MathysB21/Kubi/art/1K/Kubi - Beach eating ice cream.jpg

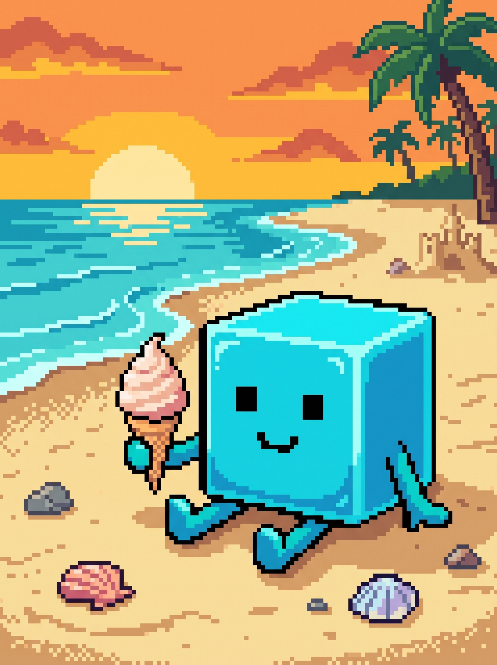
art/1K/Kubi - Beach eating ice cream.jpg
