MathysB21/Kubi/art/Scaled Down/Kubi - Birthday.jpg

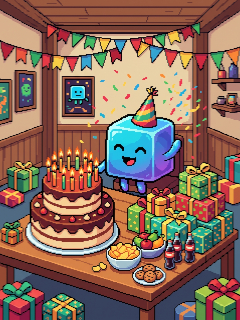
art/Scaled Down/Kubi - Birthday.jpg
