MathysB21/Kubi/docs/knowledge/index.md

# Project Kubi Knowledge Index

> [!IMPORTANT]
> **Agent Reading Rule**:
> ONLY read this index file first. Review the catalog below to find the specific document(s) relevant to your task.
> **DO NOT read all knowledge documents into context** — load only the specific document(s) you need.

## Knowledge Catalog

| Document | Date | Topics / Description |
| :--- | :--- | :--- |
| [`2026-09-05-pomodoro-idle-start-and-persistence.md`](./2026-09-05-pomodoro-idle-start-and-persistence.md) | 2026-09-05 | Pomodoro idle state (`_isStarted`), arcade slow-flashing START prompt, minimal white PAUSED UI, and pause state persistence across face changes. |
| [`2026-09-05-audio-chimes-and-long-break-fanfare.md`](./2026-09-05-audio-chimes-and-long-break-fanfare.md) | 2026-09-05 | Audio chime palette, 7-note celebratory Long Break fanfare (`CHIME_POMODORO_LONG_BREAK`), simulator telemetry chime sync, and 8-bit Web Audio. |
| [`2026-09-05-sensor-transients-and-tap-suppression.md`](./2026-09-05-sensor-transients-and-tap-suppression.md) | 2026-09-05 | False tap suppression during cube orientation flips, accelerometer delta transient handling, and gesture queue draining. |
| [`2026-09-05-focus-clock-analog-toggle-and-nvs-persistence.md`](./2026-09-05-focus-clock-analog-toggle-and-nvs-persistence.md) | 2026-09-05 | Focus Clock Face date layout, shake gesture to toggle minimalist analog view, and persistent storage across ESP32 NVS and desktop simulation HAL. |
| [`2026-09-05-system-architecture-and-sitl-simulator.md`](./2026-09-05-system-architecture-and-sitl-simulator.md) | 2026-09-05 | Hardware pinout, FreeRTOS dual-core model, Software-in-the-Loop (SITL) desktop simulator runner, mock HAL, and build runbooks. |
| [`2026-09-05-digital-twin-workbench-and-simulation-studio.md`](./2026-09-05-digital-twin-workbench-and-simulation-studio.md) | 2026-09-05 | High-fidelity Digital Twin UI, 3D cube chassis auto-orientation, dynamic Vite bundle isolation, 2-column layout, and simulated RTC time machine. |
| [`2026-09-05-gesture-sampling-deadzone-and-chime-sync.md`](./2026-09-05-gesture-sampling-deadzone-and-chime-sync.md) | 2026-09-05 | Resolution of the 20ms accelerometer sampling race condition via atomic latching, contextual face gestures, and reactive audio chime synchronization. |
| [`2026-09-06-high-level-project-architecture-and-structure.md`](./2026-09-06-high-level-project-architecture-and-structure.md) | 2026-09-06 | High-level system architecture, heritage and structural conventions from Project Sunrise, zero-button interaction paradigm, dual-target SITL design, and directory layout. |
| [`2026-09-06-dashboard-brand-migration-and-3d-wireframe-cube.md`](./2026-09-06-dashboard-brand-migration-and-3d-wireframe-cube.md) | 2026-09-06 | Dashboard title rebrand to Kubi, box.svg favicon styling, removal of SkyArc, and custom canvas-based 3D spinning wireframe cube with dynamic floor shadow. |
| [`2026-09-06-schedule-face-calendar-parser-and-empty-states.md`](./2026-09-06-schedule-face-calendar-parser-and-empty-states.md) | 2026-09-06 | Schedule Face RFC-5545 `.ics` parser, 5-day ceiling, dynamic relative day titles, pink typography, and explicit empty state messaging. |
| [`2026-09-06-embedded-finance-ticker-and-clipping-masks.md`](./2026-09-06-embedded-finance-ticker-and-clipping-masks.md) | 2026-09-06 | Embedded stock-market / finance ticker marquee rendering, static time/dash alignment, and hardware-agnostic dual-side clipping masks. |
| [`2026-09-06-schedule-pagination-and-gesture-navigation.md`](./2026-09-06-schedule-pagination-and-gesture-navigation.md) | 2026-09-06 | Strict 4-item screen pagination state machine, tap progression through sub-pages and days, and shake-to-today gesture interaction. |
| [`2026-09-06-spritesheet-slicer-and-animation-pipeline.md`](./2026-09-06-spritesheet-slicer-and-animation-pipeline.md) | 2026-09-06 | Multi-row spritesheet slicing tool with variable columns, nearest-neighbor pixel art scaling, and automated PlatformIO pre-build pipeline integration. |
| [`2026-09-06-diegetic-mascot-dioramas-and-temperature-anchors.md`](./2026-09-06-diegetic-mascot-dioramas-and-temperature-anchors.md) | 2026-09-06 | Diegetic UI design paradigm for full-screen (240×320) mascot living rooms, layered scene composition, and contextual temperature anchor coordinates. |
| [`2026-09-07-mascot-scene-selector-and-chassis-screen-geometry.md`](./2026-09-07-mascot-scene-selector-and-chassis-screen-geometry.md) | 2026-09-07 | Mascot scene selector for simulator, clean Face 3 HUD removal, sharp screen cutout corners, and symmetrical 400×400px cube chassis geometry. |
