MathysB21/Kubi/art/1K/Kubi - Christmas.jpg

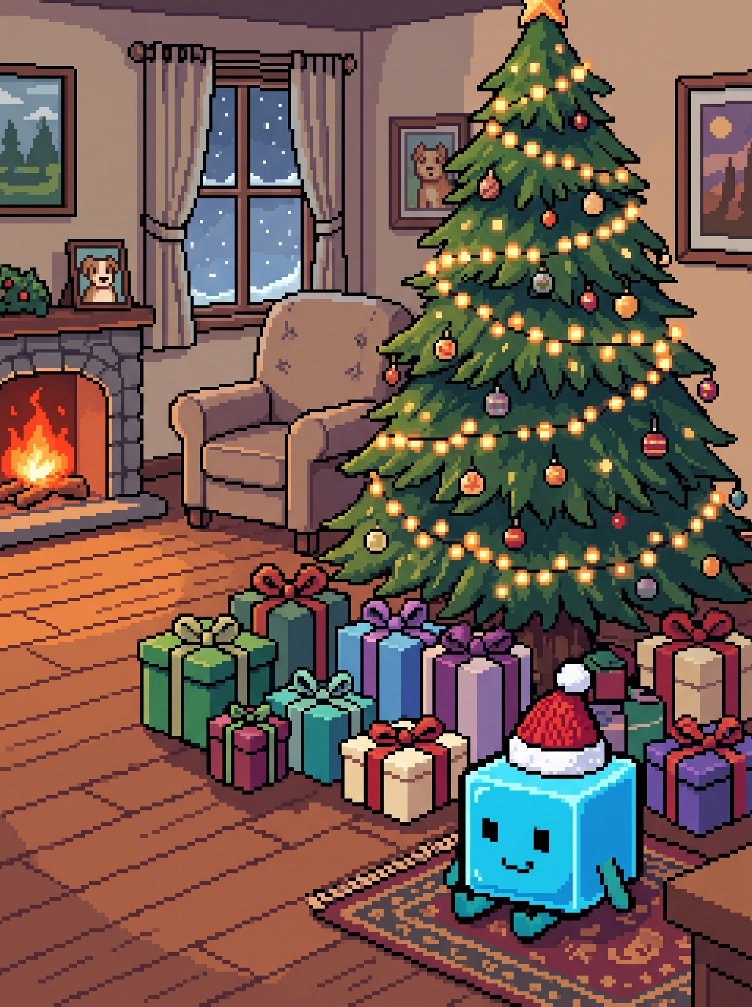
art/1K/Kubi - Christmas.jpg
