MathysB21/Kubi/art/1K/Kubi - Laying in flower field.jpg

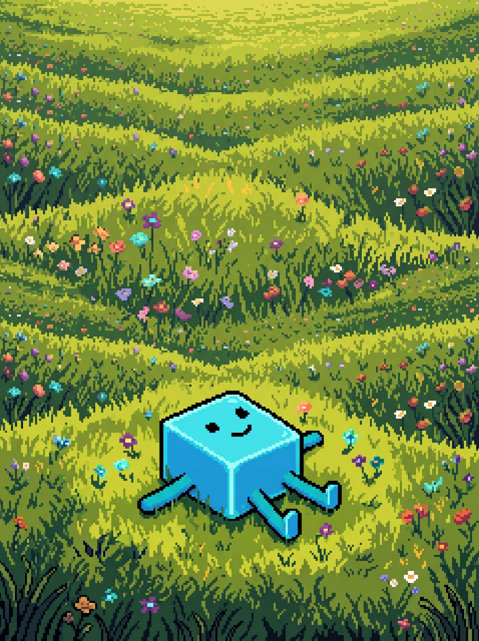
art/1K/Kubi - Laying in flower field.jpg
