MathysB21/Kubi/art/1K/Kubi - Music.jpg

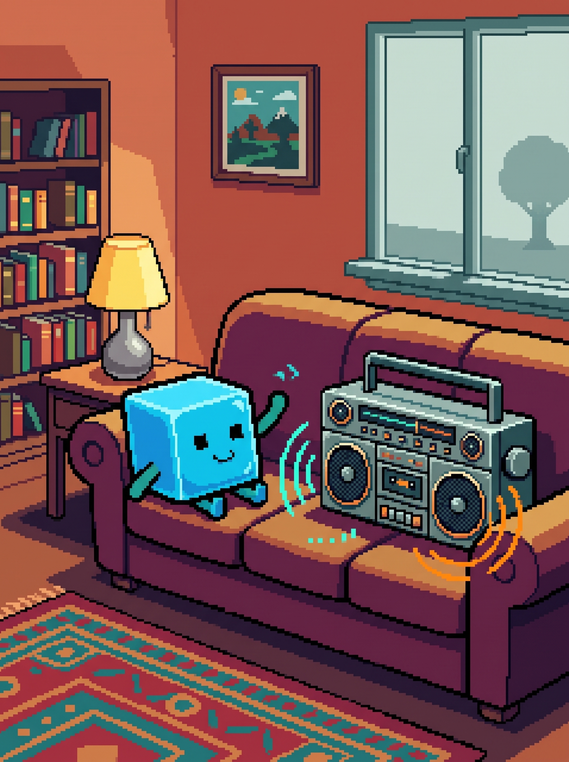
art/1K/Kubi - Music.jpg
