MathysB21/Kubi/art/1K/Kubi - Sitting by cafe.jpg

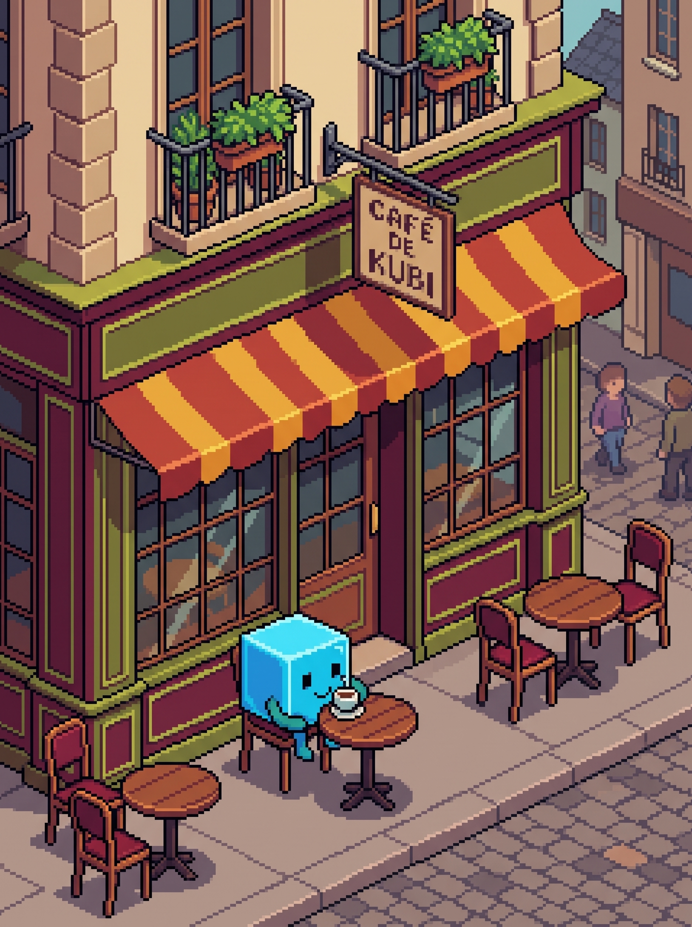
art/1K/Kubi - Sitting by cafe.jpg
