MathysB21/Kubi/art/1K/Kubi - Sleeping in bed.jpg

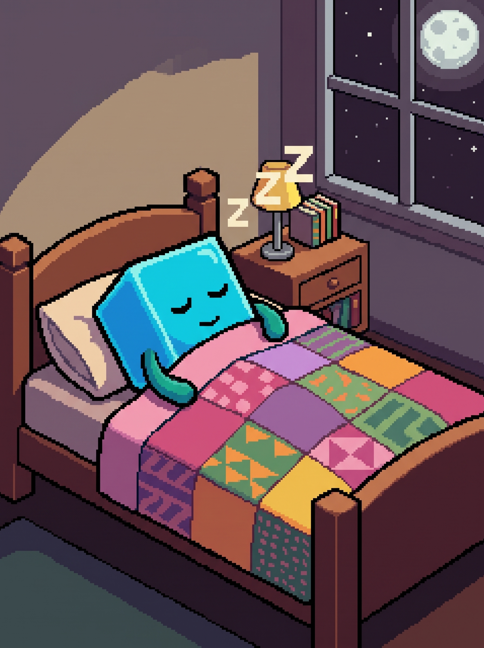
art/1K/Kubi - Sleeping in bed.jpg
