MathysB21/Kubi/art/1K/Kubi - Watching sunset.jpg

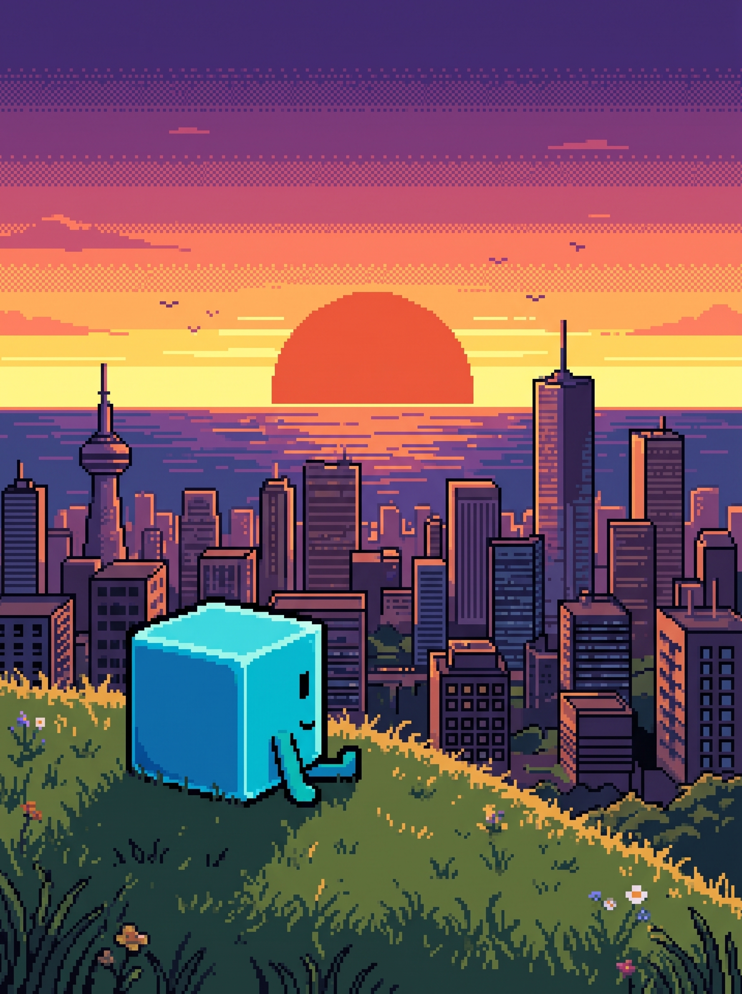
art/1K/Kubi - Watching sunset.jpg
