MathysB21/Kubi/art/1K/Kubi - Working from home.jpg

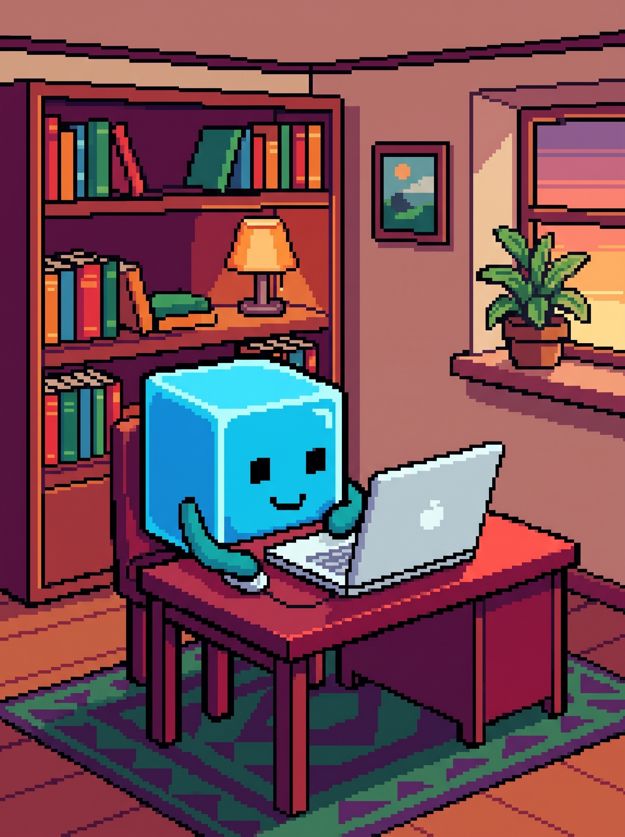
art/1K/Kubi - Working from home.jpg
