MathysB21/Kubi/art/1K/Kubi - Working out at gym.jpg

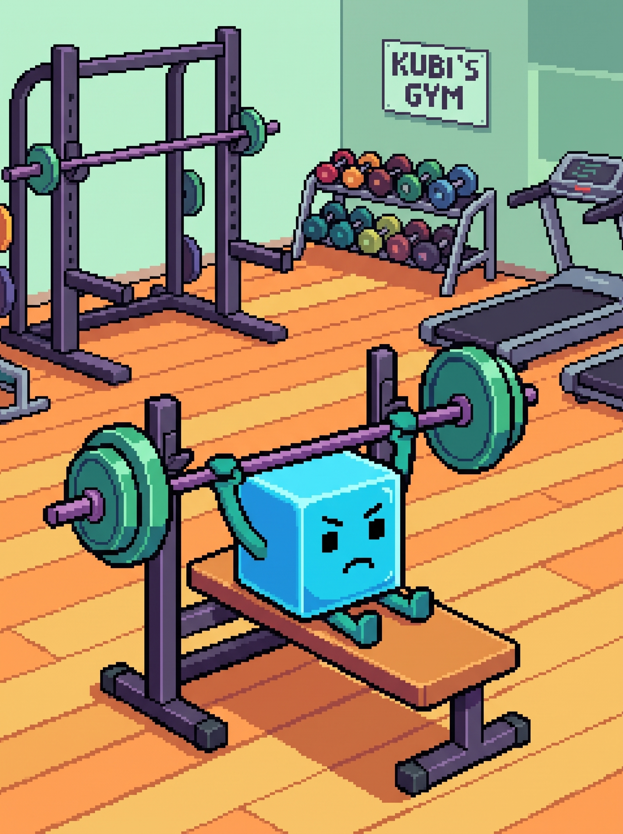
art/1K/Kubi - Working out at gym.jpg
