MathysB21/Kubi/art/Kubi - spritesheet.jpg

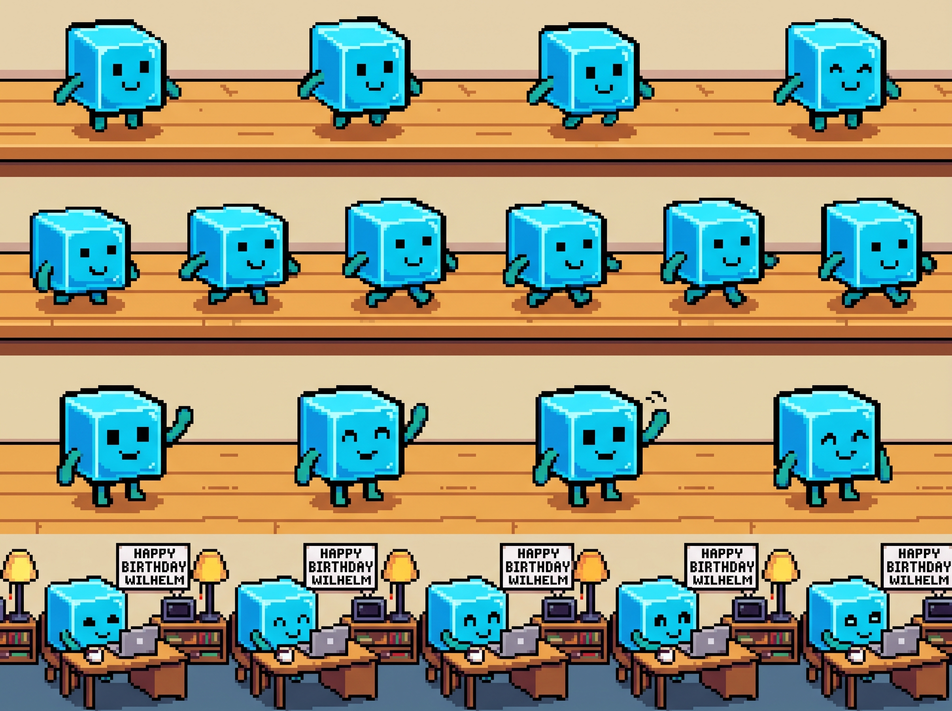
art/Kubi - spritesheet.jpg
