MathysB21/Kubi/art/palette/Color Palette 27310.png

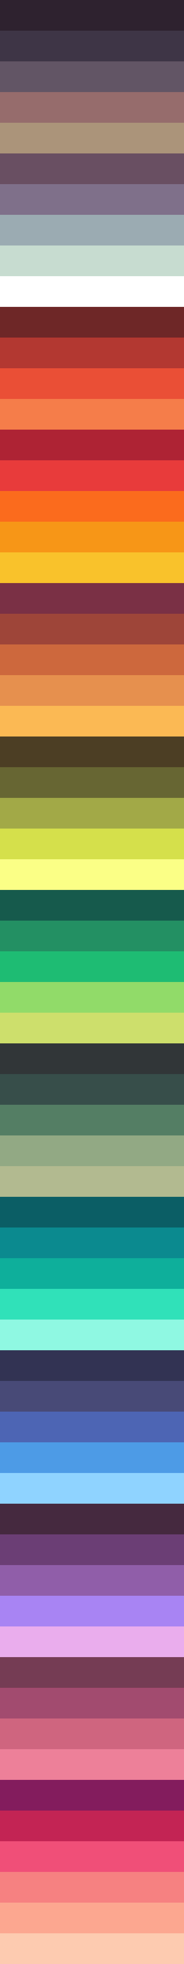
art/palette/Color Palette 27310.png
