MathysB21/Kubi/enclosure/preview/back_outside.png

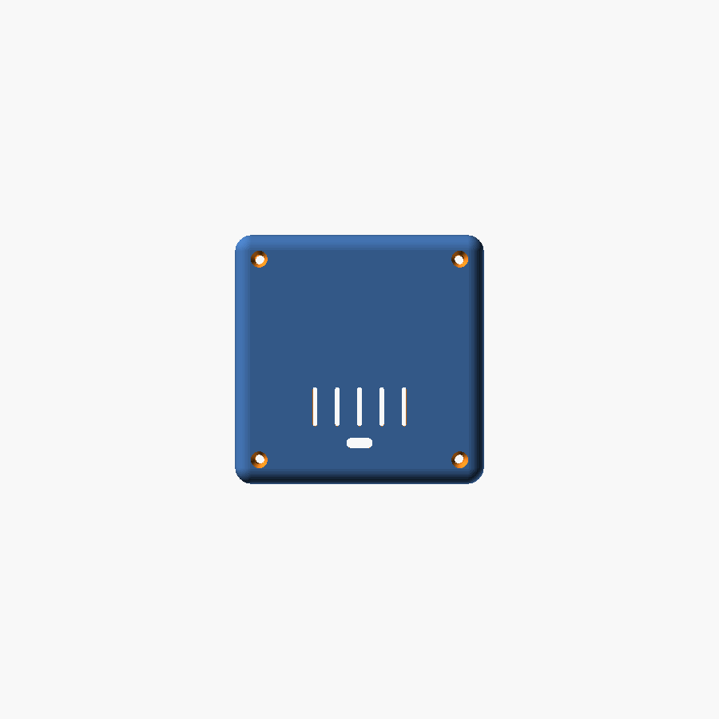
enclosure/preview/back_outside.png
