MathysB21/Kubi/enclosure/preview/exploded.png

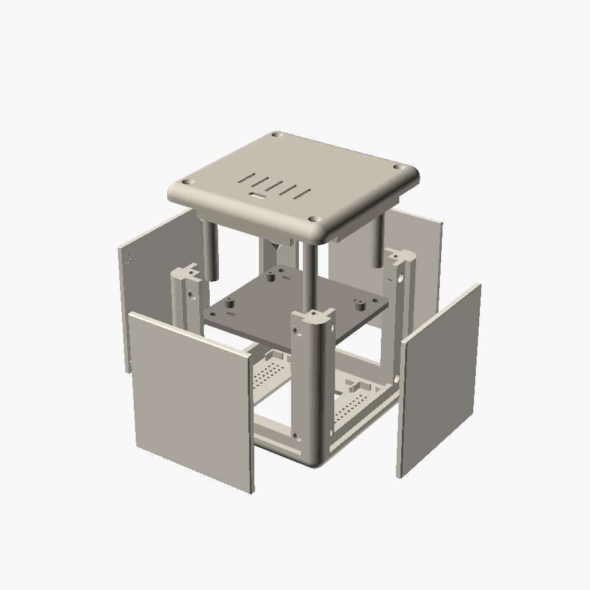
enclosure/preview/exploded.png
