MathysB21/Kubi/enclosure/stl/assembly/back.stl

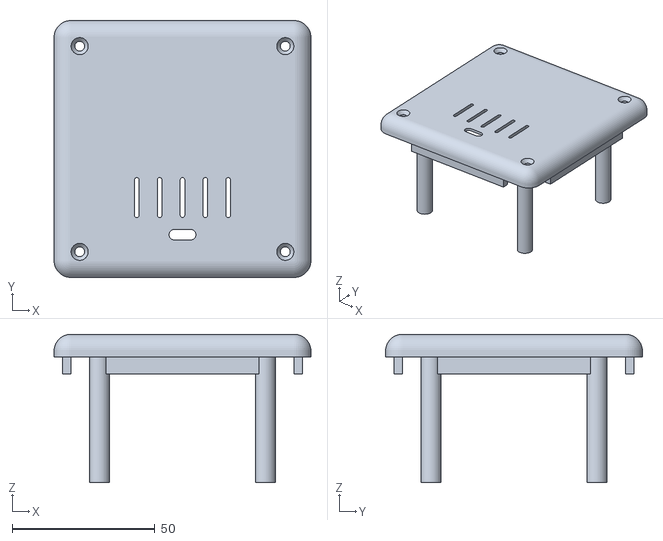
[picture p15: CAD file, 2026-10-22]
enclosure/stl/assembly/back.stl
90.0 x 90.0 x 52.0
