MathysB21/Kubi/enclosure/stl/kubi_midplate.stl

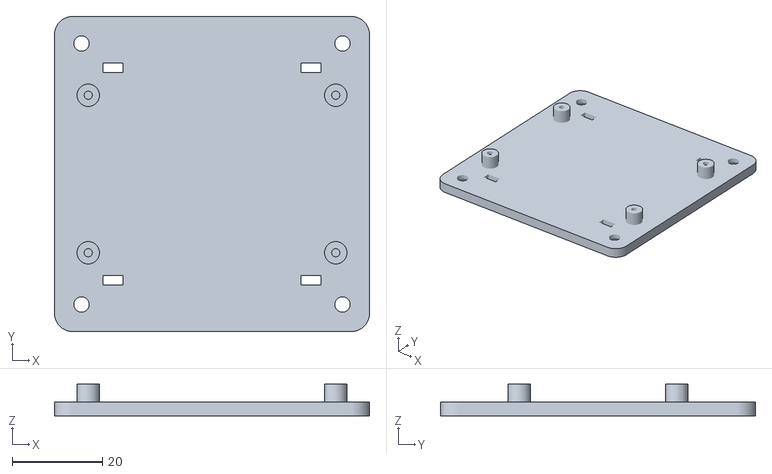
[picture p16: CAD file, 2026-10-21]
enclosure/stl/kubi_midplate.stl
70.0 x 70.0 x 7.00
