MathysB21/Kubi/(list of files, cad)

Other CAD files:
enclosure/stl/kubi_back.stl
