MathysB21/Kubi/firmware/src/API.cpp

#include "API.h"
#include <Preferences.h>
#include <AsyncJson.h>
#include <ArduinoJson.h>
#include <LittleFS.h>
#include <WiFi.h>
#include "PomodoroManager.h"
#include "DisplayManager.h"
#include "AudioManager.h"
#include "KubiScenes.h"

// --- SHARED GLOBALS (Defined in main.cpp) ---
extern volatile KubiMode currentMode;
extern volatile float roomTemperature;
extern volatile int batteryPercentage;
extern volatile float batteryVoltage;
extern volatile int batteryStateCode;
extern volatile int batteryMinutesLeft;
extern volatile int chargeAlertHigh;
extern volatile int chargeAlertLow;
extern volatile float roomPressure;

static const char* batteryStateName(int s) {
    return s == 2 ? "full" : s == 1 ? "charging" : "draining";
}
extern volatile bool isScreenOverrideActive;
extern volatile bool factoryResetRequested;
extern bool clockAnalogView;
extern int mascotSceneIndex;
extern volatile int mascotPreviewScene;
extern volatile uint32_t mascotPreviewAt;
extern volatile int birthdayMMDD;
extern volatile bool napRequested;

// Diagnostics
extern volatile float diagAccelX;
extern volatile float diagAccelY;
extern volatile float diagAccelZ;

void setupAPIRoutes(AsyncWebServer& server) {

    // =========================================================================
    // 1. GET /api/state
    // React calls this on mount and during polling intervals to fetch system state
    // =========================================================================
    server.on("/api/state", HTTP_GET, [](AsyncWebServerRequest *request) {
        AsyncResponseStream *response = request->beginResponseStream("application/json");
        JsonDocument doc;

        // Active State Data Points
        doc["mode"] = (int)currentMode;
        doc["temp"] = roomTemperature;
        doc["battery"] = batteryPercentage;
        doc["batteryVoltage"] = roundf(batteryVoltage * 100.0f) / 100.0f;
        doc["batteryState"] = batteryStateName(batteryStateCode);
        doc["batteryMinutes"] = batteryMinutesLeft; // to empty or to full, -1 = still estimating
        doc["pressure"] = roundf(roomPressure * 10.0f) / 10.0f;
        doc["chargeAlertHigh"] = chargeAlertHigh;
        doc["chargeAlertLow"] = chargeAlertLow;
        doc["mascotScene"] = mascotSceneIndex;
        doc["mascotPreview"] = mascotPreviewScene >= 0; // false: Kubi's own pick
        if (birthdayMMDD > 0) {
            char bday[8];
            snprintf(bday, sizeof(bday), "%02d-%02d", birthdayMMDD / 100, birthdayMMDD % 100);
            doc["birthday"] = bday;
        }

        // Detailed Pomodoro State
        JsonObject pomoObj = doc["pomodoro"].to<JsonObject>();
        pomoObj["phase"]         = (int)pomodoro.getPhase();
        pomoObj["phaseName"]     = pomodoro.getPhaseName();
        pomoObj["remaining"]     = pomodoro.getRemainingSeconds();
        pomoObj["total"]         = pomodoro.getTotalSeconds();
        pomoObj["isPaused"]      = pomodoro.isPaused();
        pomoObj["isStarted"]     = pomodoro.isStarted();
        pomoObj["hasChimed"]     = pomodoro.hasChimed();
        pomoObj["cycle"]         = pomodoro.getCompletedCycles();
        pomoObj["cycleTarget"]   = pomodoro.getCycleTarget();
        pomoObj["focusMin"]      = pomodoro.getFocusMinutes();
        pomoObj["shortBreakMin"] = pomodoro.getShortBreakMinutes();
        pomoObj["longBreakMin"]  = pomodoro.getLongBreakMinutes();
        pomoObj["colorWork"]     = pomodoro.getColorWorkHex();
        pomoObj["colorShort"]    = pomodoro.getColorShortBreakHex();
        pomoObj["colorLong"]     = pomodoro.getColorLongBreakHex();

        // Convenience top-level fields for backwards compatibility
        doc["pomodoroFocus"] = pomodoro.getFocusMinutes();
        doc["pomodoroBreak"] = pomodoro.getShortBreakMinutes();
        doc["clockAnalog"] = clockAnalogView;
        doc["sleepTimeoutMin"] = display.getSleepTimeoutMinutes();
        doc["isSleeping"] = display.isSleeping();
        doc["volume"] = (int)lroundf(audio.getVolume() * 100.0f);
        doc["face4Maze"] = face4Maze;

        serializeJson(doc, *response);
        request->send(response);
    });

    // =========================================================================
    // 2. POST /api/settings
    // React sends user configuration changes (face, Pomodoro, clock, sleep)
    // =========================================================================
    AsyncCallbackJsonWebHandler* settingsHandler = new AsyncCallbackJsonWebHandler("/api/settings", [](AsyncWebServerRequest *request, JsonVariant &json) {
        JsonObject jsonObj = json.as<JsonObject>();

        // 1. Mode Change
        // The core-1 loop applies the matching screen rotation; never touch the
        // TFT from this (AsyncTCP) task.
        if (jsonObj["mode"].is<int>()) {
            int mode = jsonObj["mode"].as<int>();
            if (mode >= MODE_CLOCK_IDLE && mode <= MODE_AMBIENT) {
                currentMode = (KubiMode)mode;
                display.requestWake();
            }
        }

        // 3. Pomodoro Durations
        int focus = pomodoro.getFocusMinutes();
        int sBreak = pomodoro.getShortBreakMinutes();
        int lBreak = pomodoro.getLongBreakMinutes();
        int cycles = pomodoro.getCycleTarget();
        bool durationChanged = false;

        if (jsonObj["pomodoroFocus"].is<int>()) { focus = jsonObj["pomodoroFocus"].as<int>(); durationChanged = true; }
        if (jsonObj["focusMin"].is<int>())      { focus = jsonObj["focusMin"].as<int>(); durationChanged = true; }
        if (jsonObj["pomodoroBreak"].is<int>()) { sBreak = jsonObj["pomodoroBreak"].as<int>(); durationChanged = true; }
        if (jsonObj["shortBreakMin"].is<int>()) { sBreak = jsonObj["shortBreakMin"].as<int>(); durationChanged = true; }
        if (jsonObj["longBreakMin"].is<int>())  { lBreak = jsonObj["longBreakMin"].as<int>(); durationChanged = true; }
        if (jsonObj["cycleTarget"].is<int>())   { cycles = jsonObj["cycleTarget"].as<int>(); durationChanged = true; }

        if (durationChanged) {
            pomodoro.setDurations(focus, sBreak, lBreak, cycles);
        }

        // 4. Pomodoro Colors
        String cWork  = pomodoro.getColorWorkHex();
        String cShort = pomodoro.getColorShortBreakHex();
        String cLong  = pomodoro.getColorLongBreakHex();
        bool colorChanged = false;

        if (jsonObj["colorWork"].is<const char*>())  { cWork = jsonObj["colorWork"].as<String>(); colorChanged = true; }
        if (jsonObj["colorShort"].is<const char*>()) { cShort = jsonObj["colorShort"].as<String>(); colorChanged = true; }
        if (jsonObj["colorLong"].is<const char*>())  { cLong = jsonObj["colorLong"].as<String>(); colorChanged = true; }

        if (colorChanged) {
            pomodoro.setColors(cWork, cShort, cLong);
        }

        if (jsonObj["clockAnalog"].is<bool>()) {
            clockAnalogView = jsonObj["clockAnalog"].as<bool>();
            Preferences prefs;
            prefs.begin("kubi_settings", false);
            prefs.putBool("clockAnalog", clockAnalogView);
            prefs.end();
        }

        // Mascot diorama scene: a preview for KUBI_SCENE_PREVIEW_MS, then Kubi
        // picks his own again (-1 hands back at once). Like face4Maze, the
        // hardware loop applies it; nothing here touches the display.
        if (jsonObj["mascotScene"].is<int>() && ALL_KUBI_SCENE_COUNT > 0) {
            int n = (int)ALL_KUBI_SCENE_COUNT;
            int want = jsonObj["mascotScene"].as<int>();
            if (want < 0) {
                mascotPreviewScene = -1;
            } else {
                mascotPreviewAt = millis();
                mascotPreviewScene = want % n;
                mascotSceneIndex = want % n;
            }
        }

        // Charge reminders: 0 = off, else the percent to remind at
        for (const char* key : { "chargeAlertHigh", "chargeAlertLow" }) {
            if (!jsonObj[key].is<int>()) continue;
            int pct = jsonObj[key].as<int>();
            pct = pct <= 0 ? 0 : (pct > 100 ? 100 : pct);
            bool high = key[11] == 'H';
            if (high) chargeAlertHigh = pct; else chargeAlertLow = pct;
            Preferences prefs;
            prefs.begin("kubi_settings", false);
            prefs.putInt(high ? "alertHi" : "alertLo", pct);
            prefs.end();
        }

        // Wilhelm's birthday, "MM-DD" ("" clears it): the Birthday scene's day
        if (jsonObj["birthday"].is<const char*>()) {
            const char* b = jsonObj["birthday"].as<const char*>();
            int mm = 0, dd = 0;
            int value = (sscanf(b, "%d-%d", &mm, &dd) == 2 && mm >= 1 && mm <= 12 && dd >= 1 && dd <= 31) ? mm * 100 + dd : 0;
            birthdayMMDD = value;
            Preferences prefs;
            prefs.begin("kubi_settings", false);
            prefs.putInt("bday", value);
            prefs.end();
        }

        // Face 4: Ambient (false) or Maze (true). The hardware loop notices the
        // change and switches scenes; nothing here touches the display.
        if (jsonObj["face4Maze"].is<bool>()) {
            face4Maze = jsonObj["face4Maze"].as<bool>();
            Preferences prefs;
            prefs.begin("kubi_settings", false);
            prefs.putBool("face4Maze", face4Maze);
            prefs.end();
        }

        // Chime volume, 0-100 %. A tap chime confirms the new level, so the
        // dashboard slider can be set by ear (playChime is safe from any task).
        if (jsonObj["volume"].is<int>()) {
            int v = constrain(jsonObj["volume"].as<int>(), 0, 100);
            audio.setVolume(v / 100.0f);
            Preferences prefs;
            prefs.begin("kubi_settings", false);
            prefs.putInt("volume", v);
            prefs.end();
            audio.playChime(CHIME_TAP_FEEDBACK);
        }

        // 5. Screen sleep timeout (minutes, 0 = never)
        if (jsonObj["sleepTimeoutMin"].is<int>()) {
            display.setSleepTimeoutMinutes(jsonObj["sleepTimeoutMin"].as<int>());
            Preferences prefs;
            prefs.begin("kubi_settings", false);
            prefs.putInt("sleepMin", display.getSleepTimeoutMinutes());
            prefs.end();
        }

        request->send(200, "application/json", "{\"status\":\"success\"}");
    });
    server.addHandler(settingsHandler);

    // =========================================================================
    // 3. POST /api/pomodoro/action
    // Direct dashboard controls: play, pause, toggle, skip, reset
    // =========================================================================
    AsyncCallbackJsonWebHandler* actionHandler = new AsyncCallbackJsonWebHandler("/api/pomodoro/action", [](AsyncWebServerRequest *request, JsonVariant &json) {
        JsonObject jsonObj = json.as<JsonObject>();
        if (jsonObj["action"].is<const char*>()) {
            String act = jsonObj["action"].as<String>();
            if (act == "play") {
                pomodoro.play();
            } else if (act == "pause") {
                pomodoro.pause();
            } else if (act == "toggle") {
                pomodoro.togglePause();
            } else if (act == "skip") {
                pomodoro.skipPhase();
            } else if (act == "reset") {
                pomodoro.resetCurrent();
            }
            request->send(200, "application/json", "{\"status\":\"success\"}");
        } else {
            request->send(400, "application/json", "{\"error\":\"missing action\"}");
        }
    });
    server.addHandler(actionHandler);

    // =========================================================================
    // 4. POST /api/override
    // Secret creator endpoint: push real-time text alert banners to Kubi's screen
    // =========================================================================
    AsyncCallbackJsonWebHandler* overrideHandler = new AsyncCallbackJsonWebHandler("/api/override", [](AsyncWebServerRequest *request, JsonVariant &json) {
        JsonObject jsonObj = json.as<JsonObject>();

        if (jsonObj["message"].is<const char*>()) {
            setOverrideText(jsonObj["message"].as<const char*>());
            isScreenOverrideActive = true; // Set after the text so the reader never sees a stale banner
            display.requestWake();
            Serial.printf("[OVERRIDE] Custom alert received: %s\n", getOverrideText().c_str());
            request->send(200, "application/json", "{\"status\":\"alert_displayed\"}");
        } else {
            request->send(400, "application/json", "{\"error\":\"missing message field\"}");
        }
    });
    server.addHandler(overrideHandler);

    // =========================================================================
    // 5. GET /api/diagnostics
    // Real-time telemetry: IMU axes, temperature, battery, WiFi signal
    // =========================================================================
    server.on("/api/diagnostics", HTTP_GET, [](AsyncWebServerRequest *request) {
        AsyncResponseStream *response = request->beginResponseStream("application/json");
        JsonDocument doc;

        doc["accelX"] = diagAccelX;
        doc["accelY"] = diagAccelY;
        doc["accelZ"] = diagAccelZ;
        doc["temp"] = roomTemperature;
        doc["battery"] = batteryPercentage;
        doc["batteryVoltage"] = roundf(batteryVoltage * 100.0f) / 100.0f;
        doc["batteryState"] = batteryStateName(batteryStateCode);
        doc["batteryMinutes"] = batteryMinutesLeft; // to empty or to full, -1 = still estimating
        doc["pressure"] = roundf(roomPressure * 10.0f) / 10.0f;
        doc["chargeAlertHigh"] = chargeAlertHigh;
        doc["chargeAlertLow"] = chargeAlertLow;
        doc["rssi"] = WiFi.RSSI();
        doc["freeHeap"] = ESP.getFreeHeap();
        doc["uptime"] = millis() / 1000;
        doc["mode"] = (int)currentMode;

        serializeJson(doc, *response);
        request->send(response);
    });

    // =========================================================================
    // POST /api/nap: Kubi says good night and deep-sleeps until picked up.
    // Only sets the flag; the hardware loop draws, configures and sleeps.
    // =========================================================================
    server.on("/api/nap", HTTP_POST, [](AsyncWebServerRequest *request) {
        napRequested = true;
        request->send(200, "application/json", "{\"status\":\"napping\"}");
    });

    // =========================================================================
    // 6. POST /api/factory-reset
    // Wipes settings, saved networks and stored WiFi, then restarts into setup.
    // Requires {"confirm":"ERASE"} so a stray request cannot trigger it.
    // =========================================================================
    AsyncCallbackJsonWebHandler* resetHandler = new AsyncCallbackJsonWebHandler("/api/factory-reset", [](AsyncWebServerRequest *request, JsonVariant &json) {
        JsonObject jsonObj = json.as<JsonObject>();
        const char* confirm = jsonObj["confirm"] | "";
        if (strcmp(confirm, FACTORY_RESET_CONFIRM) == 0) {
            factoryResetRequested = true; // hardware loop does the wipe after we reply
            request->send(200, "application/json", "{\"status\":\"resetting\"}");
        } else {
            request->send(400, "application/json", "{\"error\":\"confirm required\"}");
        }
    });
    server.addHandler(resetHandler);

    // =========================================================================
    // 7. SERVE STATIC REACT FRONTEND FROM LITTLEFS /www
    // Only the web build lives under /www (Vite outDir firmware/data/www), so
    // nothing else on the filesystem is reachable over HTTP.
    // =========================================================================
    server.serveStatic("/", LittleFS, "/www/").setDefaultFile("index.html");

    // Client-side routes (/manual) have no file: hand them the SPA shell.
    server.onNotFound([](AsyncWebServerRequest *request) {
        if (request->method() == HTTP_GET && !request->url().startsWith("/api/")) {
            request->send(LittleFS, "/www/index.html", "text/html");
        } else {
            request->send(404, "application/json", "{\"error\":\"not found\"}");
        }
    });
}
