MathysB21/Kubi/firmware/sim/include/pgmspace.h

#pragma once
#include <cstdint>
#include <cstring>

#ifndef PROGMEM
#define PROGMEM
#endif

#ifndef PSTR
#define PSTR(s) (s)
#endif

#define pgm_read_byte(addr)   (*(const uint8_t*)(addr))
#define pgm_read_word(addr)   (*(const uint16_t*)(addr))
#define pgm_read_dword(addr)  (*(const uint32_t*)(addr))
#define pgm_read_float(addr)  (*(const float*)(addr))
#define pgm_read_ptr(addr)    (*(const void* const*)(addr))
