MathysB21/Kubi/(commit log)

2026-09-05 Setup project structure, add pomodoro timer
    [partitions.csv]
2026-09-05 feat(sim): add native C++ SITL hardware simulation environment and desktop HAL
    - Implement Software-in-the-Loop (SITL) desktop runner compiling real firmware sources
    - Add Desktop HAL mocks for Adafruit ADXL345, BMP280, TFT_eSPI, I2S audio, and Arduino APIs
    - Implement HTTP REST server for raw RGBA framebuffer streaming (/sim/frame), telemetry (/sim/state), and sensor/gesture injection (/sim/inject)
    - Support atomic gesture queueing and simulated time overrides
2026-09-05 feat(dashboard): add digital twin hardware workbench with web audio synthesizer
    - Add interactive Kubi Hardware Simulation Studio at /sim
    - Render realistic wooden desk companion cube with brass machine screws and ST7789 IPS display
    - Add auto-orientation roll animation when entering widescreen modes
    - Add 8-bit retro square-wave Web Audio synthesizer for tactile chime feedback
    - Add 2-column layout for BMP280 temperature, battery, override banners, and time scrubber with presets
    - Implement dynamic code-splitting via React.lazy() for zero overhead on ESP32 Silicon builds
2026-09-05 build(dashboard): update compiled frontend assets for ESP32 flash
    - Rebuild production assets for LittleFS partition
    - Maintain clean bundle isolation with Simulator code-split into independent chunk
2026-09-05 fix(clock): remove legacy detail overlay on clock face and prevent orientation false taps
    [DisplayManager.cpp, SensorManager.cpp, main.cpp, sim_main.cpp]
2026-09-05 fix(pomodoro): minimal white paused indicator and persist pause state across faces
    [DisplayManager.cpp, SensorManager.cpp, main.cpp, sim_main.cpp]
2026-09-05 feat(dashboard): rebrand to Kubi, update favicon, add 3D spinning wireframe cube
2026-09-06 feat(firmware): redesign schedule face with pink typography, 5-day ceiling, finance ticker marquee, and empty states
    [API.cpp, DisplayManager.cpp, DisplayManager.h, main.cpp]
2026-09-06 chore(sim): make WinGet clang search path dynamic across machines
2026-09-07 feat(sim): add mascot idle scene selector and sharp symmetrical chassis geometry
2026-09-07 docs: record session knowledge for mascot scene selector and chassis screen geometry
2026-09-21 fix(firmware): start I2S output and feed it from a dedicated audio task
    AudioManager::init() never called begin(), so ConsumeSample() discarded
    every sample. Even with begin(), the synth pushed 64 samples per ~10 ms
    loop tick (~29% of 22,050 Hz). Synthesis now runs in its own FreeRTOS task
    (core 1, prio 2) that yields while the DMA queue is full, so it is paced by
    the sample clock. Note lengths are counted in samples instead of millis().
    playChime()/stop() post to an atomic mailbox and are safe from any task.
    If the queue refuses samples for 200 ms, audio disables itself instead of
    spinning.
    The sim mock now refuses samples before begin(), drains a queue the size of
    the real DMA ring at the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
    [AudioManager.cpp, AudioManager.h, AudioOutputI2S.h, main.cpp, sim_main.cpp]
2026-09-21 feat(firmware): inactivity screen sleep with wake on tap or motion
    Sleep was unreachable: only wakeScreen() armed the timer, and only a
    sleeping screen could call it. The policy now lives in the shared
    DisplayManager: the orchestration loop reports activity (face change,
    gesture, motion above 1.5 m/s^2) and whether the current face may sleep.
    After the timeout the backlight fades out; any activity wakes it instantly
    and silently, swallowing the waking gesture.
    Per the 21 Sep decision only Mascot sleeps (modeMaySleep in API.h); Clock,
    Pomodoro and Face 4 stay on, as does a pending override message. The
    timeout defaults to 5 min, persists in NVS (kubi_settings/sleepMin), is
    exposed as sleepTi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
2026-09-21 fix(dashboard): show a disconnected state instead of fake default data
    The state query caught every failure and returned DEFAULT_STATE, so an
    offline cube rendered as 100% battery, 22.0 C and a 25:00 timer. The query
    now throws on failure. Before first contact the dashboard shows "Can't
    reach Kubi" with a retry. After losing a live connection it keeps the last
    real state, dimmed and non-interactive, under a banner with its timestamp.
    TSK-396
2026-09-21 fix(firmware): guard the override banner text across cores
    screenOverrideText was a String written by the AsyncTCP task and read by
    the core-1 render loop. An assignment frees the old buffer, so a render
    preempted mid-draw could read freed memory, which is the classic random
    reboot. The text now lives in a fixed 128-byte buffer behind
    setOverrideText()/getOverrideText(). The lock holds only a bounded memcpy
    (portMUX on hardware, no heap work with interrupts masked; std::mutex in
    the sim) and the reader builds its String outside the lock.
    secretIcalUrl is left alone: it goes away with the calendar face (TSK-422).
    TSK-389
    [API.cpp, API.h, main.cpp, sim_main.cpp]
2026-09-21 fix(firmware): apply face rotation when the dashboard changes mode
    The hardware /api/settings handler set currentMode but never rotated the
    screen, so a dashboard face change rendered sideways on the cube while
    looking right in the sim. Both loops now call setRotationForFace(currentMode)
    each tick (a no-op unless it changed). That keeps TFT/SPI access on the
    render core instead of the web-server task, where the sim used to do it.
    Mode values outside 0-3 are now rejected on both targets.
    TSK-392
    [API.cpp, main.cpp, sim_main.cpp]
2026-09-21 fix(dashboard): serve the web app from /www and keep /sim off the cube
    serveStatic mapped "/" to the LittleFS root, so any file on the filesystem
    (e.g. /calendar.ics) was readable on the LAN. Vite now builds to
    firmware/data/www and the firmware serves only /www/. An onNotFound
    fallback returns the SPA shell for client routes such as /manual, which
    previously 404'd on reload.
    The /sim workbench can only talk to kubi_sim.exe on 127.0.0.1:8080, yet its
    chunk was flashed to the cube. A compile-time __KUBI_SIM__ flag, true only
    under the Vite dev server (npm run dev / npm run sim), gates the route, the
    lazy import and the footer link, so the production build emits no
    Simulator chunk.
    TSK-390,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
    [API.cpp]
2026-09-21 perf(firmware): repaint only what changed instead of fillScreen every frame
    Every draw path cleared the whole 240x320 panel and redrew everything at
    20 Hz: ~31 ms of SPI per 50 ms frame just for the clear. DisplayManager now
    tracks the current scene and the last-drawn values per face. The full
    clear happens only on a scene change, a rotation or invalidate().
    Otherwise:
    - clocks return immediately unless the minute or date changed;
    - the analog clock wipes only the hand disc, and the numerals stay;
    - Pomodoro overdraws the timer, phase, session and status rows in place
    (opaque text + setTextPadding) and extends or trims only the changed span
    of the progress bar;
    - Mascot repaints only on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
2026-09-21 feat(firmware): ambient glow face in the Face 4 slot
    Face 4 now shows a slow pixel-art glow for a dark room instead of the
    calendar agenda. A dithered orb of 8 px cells breathes over 9 s and eases
    through midnight blue, teal, violet, ember and rose (40 s per colour). The
    backlight fades down to 48/255 on this face (new setAwakeBrightness, with
    the backlight fade now working in both directions), the face is exempt
    from sleep, and a tap silently moves on to the next colour.
    It redraws at 10 Hz and pushes only the cells whose colour changed, about
    7.7k px/s, roughly a tenth of one full-screen clear per second.
    MODE_SCHEDULE_AGENDA becomes MODE_AMBIENT on both targets. The schedule
    code itself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
2026-09-21 fix(firmware): stop the setup portal serving saved WiFi passwords
    The Kubi-Setup hotspot is open, and the portal page embedded every saved
    network as {"ssid":"password"} in a <script>, so anyone who joined it
    could read them, or reveal one in the field with the eye toggle. SSIDs
    were also concatenated into the JS unescaped.
    The page now receives only knownNetworks = ["ssid", ...]. Values are
    emitted as JS string literals with quotes and backslashes escaped and
    < > & and control characters as \u00XX, so an SSID cannot close the
    script. Picking a known network leaves the password blank with a
    "Saved on Kubi - leave blank" hint. On submit, the vendored WiFiManager
    calls a new setSavedPasswordR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
    [main.cpp]
2026-09-21 feat(firmware): factory reset and a first-boot flow that feels intentional
    Wilhelm will set Kubi up himself, like a new product:
    - Factory reset: POST /api/factory-reset with {"confirm":"ERASE"} raises
    a flag. The hardware loop shows a reset screen, clears the kubi_settings
    and wifi_memory NVS namespaces, erases the ESP32's stored STA
    credentials (WiFi.disconnect(true, true)) and restarts into setup. The
    dashboard gets a Factory Reset section with an explicit confirm step.
    The sim mirrors the endpoint; since it cannot reboot, it reloads
    defaults and replays onboarding (setup screen, then the address screen).
    - Setup screen: while the Kubi-Setup hotspot is up, the display walks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
    [API.cpp, API.h, DisplayManager.cpp, DisplayManager.h, main.cpp, sim_main.cpp]
2026-09-21 refactor(firmware): table-driven face map shared by sensors, display and sim
    Face detection (an if-chain in SensorManager), screen rotation (a table in
    DisplayManager) and the sim's face buttons (hard-coded gravity vectors)
    each encoded their own idea of which way up the cube is. FaceMap.h now
    holds one table, gravity axis + sign -> face -> rotation. Face detection
    classifies against it, setRotationForFace reads it, and /sim/inject
    {"face": n} derives its gravity vector from it, so the bring-up values
    only need entering once.
    Behaviour is unchanged. The rows reproduce the old guess, and a
    2M-vector comparison with the old if-chain (ties included) shows no
    difference. The table is marked "FI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
2026-09-21 fix(firmware): echo the picked Pomodoro colour instead of a lossy round-trip
    /api/state rebuilt each colour from its RGB565 value, and 888 -> 565 -> 888
    is not identity (#F59E0B came back as #F69D08). So the dashboard swatch
    drifted on every reload and its "selected" ring never matched a preset.
    PomodoroManager now keeps the normalised hex (#RRGGBB, uppercase; invalid
    input becomes #FFFFFF, matching the 565 fallback) in fixed buffers, echoes
    it, and persists it.
    TSK-398
    [PomodoroManager.cpp, PomodoroManager.h]
2026-09-21 chore(firmware): sweep dead code left behind by earlier iterations
    - drawClockFace took showDetails, nextEvent and ticker and ignored all
    three; both loops passed hard-coded "Design Review 14:00" and a fake stock
    ticker. The parameters and the two convenience overloads are gone.
    - clockShowDetails / clockDetailsTimeout were maintained every frame and
    never rendered: removed from both loops.
    - KubiState in the dashboard declared night-mode, dawn/dusk, alarm and
    sundown fields that no firmware API has ever sent: removed.
    - rgb565ToHex is unused since the hex is echoed (TSK-398): removed.
    - A no-op ternary in the sim, a stale API.h comment, an unused include.
    - Deleted the stale, gitign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
2026-09-21 feat(sim): continuous tilt injection from the workbench
    The maze needs steady tilt input, and the workbench could only snap between
    face orientations. /sim/inject now accepts tiltRoll/tiltPitch in degrees
    (+roll = right side down, +pitch = top edge away), relative to the current
    face resting flat, clamped to +/-35 degrees so tilt never reads as a face
    change. /sim/state reports both.
    The tilt maths lives in FaceMap.h, not in the browser: tiltedGravity()
    rotates the face's resting vector in a screen frame (up, right = up x out,
    out). The screen's outward axis is a new "fill in from bring-up" constant.
    The maze steers with the same frame, so the sim and the firmware cannot
    disagree about whic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
    [FaceMap.h, sim_main.cpp]
2026-09-21 feat(firmware): maze board format and renderer on an optional Face 4
    Boards are hand-drawn 20x14 ASCII ('#' wall, ' ' floor, S start, G goal,
    O hole) and are validated on load (shape, closed outer wall, exactly one
    S and one G). Invalid boards are skipped so one can never strand the face.
    The renderer sizes cells from the screen (16 px in landscape under a
    16 px HUD strip, centred if bring-up turns Face 4 portrait), draws
    pixel-art walls in the chassis' wood tones, a gold checker goal and holes,
    and after the first frame repaints only the ball: the cells under its old
    bounding box, then the ball. A harness shows incremental frames identical
    to full repaints in both orientations; a still fram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
    [API.cpp, API.h, DisplayManager.cpp, DisplayManager.h, MazeBoards.cpp, MazeBoards.h, MazeGame.cpp, MazeGame.h]
2026-09-21 feat(firmware): maze ball physics steered by tilt relative to rest
    The ball moves in a fixed 200 Hz step, in cell units. At board start the
    resting accelerometer vector is averaged for 250 ms. Steering is the
    low-passed deviation from it, projected onto the maze face's screen axes
    from FaceMap.h (the same frame the sim's tilt pad uses), with a 0.35 m/s^2
    deadzone for sensor noise. So the cube never needs to sit level, and
    steering never fights face detection by reading absolute tilt.
    Walls collide as circle vs. cell with a damped reflection, so the ball
    rolls off corners. Tunnelling cannot happen: at the 9 cells/s cap a step
    moves 0.045 cells against a 0.32-cell radius and 1-cell walls. Fra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
    [MazeGame.cpp, MazeGame.h, main.cpp, sim_main.cpp]
2026-09-21 feat(firmware): lock the maze face while playing, with a hold-to-exit
    Tilting past 45 degrees during play makes another axis dominant, which
    would flip the cube to another face mid-game. While the maze is being
    played, a new face must now hold for 2 s instead of 400 ms
    (SensorManager::setFaceSettleTime). Normal play never holds another face
    that long, and the exit gesture is just that: roll the cube onto another
    face and hold it.
    "Playing" means deliberate tilt (1.5x the deadzone) within the last 45 s,
    so the lock lets go by itself when the maze is left alone and can never
    strand the cube on Face 4. Taps no longer change the Ambient colour while
    Face 4 shows the maze. Both loops log lock on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
    [MazeGame.cpp, MazeGame.h, SensorManager.cpp, SensorManager.h, main.cpp, sim_main.cpp]
2026-09-21 feat(firmware): maze game loop with holes, goal, timer, chimes and best times
    MazeGame is now a game: READY (ball on S, "tilt to start") -> RUNNING (the
    clock starts on the first deliberate tilt) -> FALLING (the ball shrinks
    into a hole for 0.5 s and respawns on S; the clock keeps running, which is
    the penalty) -> WON (a time banner and "NEW BEST!" for 3 s, then the next
    board). The HUD shows board number, name, live tenths and the board's best,
    repainting only when the text changes. A board change repaints once;
    everything else is still ball-only.
    Chimes: slam "ouch" on a fall, the Pomodoro-done arpeggio on the goal, and
    the long-break fanfare on a new best. Best time per board (mzb<n>) an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
2026-09-21 feat(firmware): ten hand-drawn maze boards, easiest first
    1 First Steps (warm-up), 2 Switchback (long zig-zag), 3 Mind the Gap
    (first holes), 4 Pillars (open room, weave between posts), 5 The Snail
    (spiral in to the middle), 6 Crossroads (branches, two holes in dead ends),
    7 Labyrinth (proper maze), 8 Hole in One (a field of holes), 9 Tightrope
    (lanes between hole rows), 10 The Gauntlet (finale).
    Each board was checked for a hole-free route from S to G, then cleared by
    the autopilot through the real physics (11.6 s to 48.9 s). Rendering
    stayed pixel-identical to full repaints throughout, and 120 s of random
    tilt per board never overlaps a wall or escapes. Hole rims are lighter so
    holes read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
    [MazeBoards.cpp, MazeGame.cpp]
2026-10-06 build(firmware): add a USB upload environment for the first flash
    esp32dev uploads over WiFi (espota), which a blank board cannot receive.
    esp32dev_usb extends it with esptool and an auto-detected port.
    default_envs keeps a plain `pio run` building only esp32dev.
2026-10-06 fix(firmware): two OTA app slots so WiFi updates can work
    The table had a single app partition, and the ESP32 cannot overwrite the
    slot it is running from, so every espota upload would fail. app0/app1
    are now 1.5 MB each (firmware is 1.17 MB, 74%) and LittleFS shrinks from
    1.8 MB to 960 KB (data/ is ~550 KB). NVS keeps its offset, so settings
    survive. Needs one USB flash to write the new table.
    [partitions.csv]
2026-10-06 fix(firmware): build with the committed sprites when Pillow is missing
    build_sprites.py called sys.exit(0) when Pillow was not importable. Under
    PlatformIO that ends the SCons run early and still prints SUCCESS, with
    nothing compiled or uploaded. build_scenes.py would instead fail on the
    import. Both now print a warning and keep the committed generated sources.
2026-10-06 fix(firmware): shakes no longer read as taps or get swallowed
    First run on hardware: shaking registered as taps, and only the first
    shake toggled the clock even though every shake was logged.
    - A shake's first jolt passed the tap test, so a shake on Pomodoro paused
    the timer before skipping it. Taps now wait 250 ms as a candidate and
    are cancelled if a second X reversal follows.
    - updateFace() cleared any gesture when the dominant axis changed. A hard
    shake flips it, so a shake could be logged and then erased before
    main.cpp read it. Orientation changes now drop only taps.
    - One bout of shaking now reports one shake: reversals within 600 ms of a
    reported shake extend the hold-off.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
    [SensorManager.cpp, SensorManager.h]
2026-10-07 fix(firmware): OTA updates no longer crash the cube on start
    Every WiFi upload rebooted the cube at "UPDATE STARTED" with
    assert failed: xQueueGenericSend queue.c:832 (...xMutexHolder...)
    and espota reported "No response from device".
    ArduinoOTA's onStart runs in loop()'s task and called
    display.drawBootScreen() while core1HardwareTask was drawing. TFT_eSPI keeps
    its SPI "locked" flag on the shared TFT object, so the render task ended a
    transaction it never began and gave back the SPI bus mutex the OTA task
    held. Backtrace (decoded against the flashed commit): core1HardwareTask ->
    drawClockFace -> beginScene -> fillScreen -> end_tft_write ->
    spiEndTransaction -> xQueueGenericSend assert.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
    [main.cpp]
2026-10-07 feat(firmware): keep the last crash in a coredump partition
    The OTA crash printed "Core dump flash config is corrupted" because the
    table had nowhere to put a dump, so finding it took a USB serial capture
    during a repro. The framework already writes ELF core dumps to flash
    (CONFIG_ESP_COREDUMP_ENABLE_TO_FLASH); it only lacked the partition.
    - partitions.csv: 64 KB coredump at 0x3F0000, LittleFS 960 KB -> 896 KB
    (data/ is 534 KB; buildfs produces exactly 0xE0000).
    - Boot logs "[CRASH] A core dump from an earlier crash is stored" when
    esp_core_dump_image_get() finds a valid one.
    - tools/read_coredump.ps1 reads it over USB and decodes it with
    esp-coredump and PlatformIO's xtensa gdb.
    Ne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
    [partitions.csv]
2026-10-07 build(firmware): pin library versions so USB and OTA builds match
    Each PlatformIO environment installs its own libdeps. With ^ ranges,
    esp32dev_usb (first installed today) resolved ESPAsyncWebServer 3.12.1
    and AsyncTCP 3.5.0 while esp32dev kept 3.10.3 and 3.4.10, so the code on
    the cube depended on whether it was flashed over USB or WiFi, and a core
    dump would only decode against the matching build.
    All lib_deps are now exact, at the set esp32dev had (what the cube runs
    and what has been tested), with the transitive AsyncTCP and BusIO listed
    so they are pinned too. Both environments now build the same versions.
    read_coredump.ps1 defaults to the most recently built of the two ELFs.
    Co-Auth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
2026-10-07 feat(firmware): face table measured on hardware
    FaceMap.h held the pre-bring-up guess (faces on +Z, +X, +Y, -X), which
    left one face unreachable. tools/capture_faces.ps1 walks through the four
    resting positions, averages /api/diagnostics at each, checks they form
    two opposite axis pairs, and prints the table. Measured today with the
    sensor and display on the breadboard:
    Face 1 Clock +X ( 9.9, -0.2, -2.7)
    Face 2 Pomodoro -Y ( 0.2, -10.5, -2.4)
    Face 3 Mascot -X (-10.5, -0.4, -0.9)
    Face 4 Ambient +Y (-0.5, 10.2, -1.3)
    screen out +Z (up(Face 2) x up(Face 1); matches flat, screen up)
    Z reads ~-1.5 on every face: this ADXL345's zero-g offset. Replaying the
    readings th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
2026-10-07 fix(firmware): detect shakes on every face, not only when X is free
    Shake detection counted sign reversals of raw X past +/-3 m/s^2. With
    the measured face table, standing upright puts gravity on X (Faces 1
    and 3) or Y (Faces 2 and 4). On Faces 1 and 3 X sits at ~+/-10, so a
    shake had to swing more than 1.3 g each way to register, and on Faces 3
    and 4 the jolts were confirmed as taps instead. Clock's analog toggle and
    Mascot's previous-scene would almost never have worked on the real cube.
    Reversals are now counted per axis on the reading minus a slow gravity
    estimate (alpha 0.04 at 50 Hz, ~0.5 s), so a shake looks the same on any
    face and in any direction. Upright replay, each measured fac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
    [SensorManager.cpp, SensorManager.h]
2026-10-07 feat(firmware): play chimes through the ESP32's DAC into a PAM8403
    No MAX98357A (or NS4168 clone) is in stock locally, so audio now leaves
    the ESP32's own 8-bit DAC on GPIO 25 (L) and 26 (R) into a PAM8403
    analog stereo amp, one laptop speaker per channel. KUBI_AUDIO_INTERNAL_DAC
    in platformio.ini selects it; without the flag the MAX98357A I2S path is
    exactly as before.
    The DAC plays around mid-scale (1.65 V) but the DMA idles at 0 V, and a
    1.65 V step through the amp's ~24 dB is a pop at the start and end of
    every chime. AudioManager fades the level up over 60 ms before the first
    note and down over 200 ms after the last (raised cosine), and a chime
    requested mid-fade continues from the cur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
2026-10-08 docs: power from the 18650 holder, battery-sense divider, solder checklist
    The wiring guide still described a generic power-bank module. It now
    covers the DFRobot 2 x 18650 holder (HOLD mode, 5V out only, its USB-C as
    the cube's charge port), a battery-sense divider for the percentage
    (100k/100k from battery + to GND, midpoint and a 100 nF cap on GPIO 34,
    an ADC1 pin that works alongside WiFi; R1 soldered at the battery clip so
    the long wire is current-limited), and a from/to checklist of every
    connection for soldering the perfboard. README pin table gets GPIO 34.
2026-10-12 docs: 90 mm cube layout and hole-by-hole perfboard plan
    The DFRobot 2 x 18650 board is 104 mm long and would need a ~120 mm cube
    with the charge port on the back, so power is now the bare 2 x 18650
    holder (parallel) -> protected TP4056 (USB-C, the charge port) -> MT3608
    set to 5.0 V, all parts already on hand.
    The wiring guide gets the cube layout (90 mm printed, 3 mm walls):
    screen front with a speaker firing forward either side, battery centred
    behind the screen on the roll axis, perfboard with ESP32 + IMU in the
    middle, TP4056 / MT3608 / PAM8403 on the back wall with USB-C and the
    volume knob through it. Plus a 14 x 20 perfboard plan (ESP32 sockets,
    connector headers, divider placement),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
2026-10-12 docs: perfboard plan for the actual ESP32 board and parts on hand
    The ESP32's pin rows are 9 holes apart, so the second socket moves to row K and every K-side wire in the list follows. Socket pin order is confirmed against the board's pinout (30-pin DevKit, ESP32-D0WD-V3, CH340, USB-C). The battery divider uses 10k/10k (the largest on hand), which the ADC can sample without the 100 nF capacitor, now optional; it draws ~0.2 mA. 26 AWG stranded is fine for every run, including the battery leads. The PAM8403 volume knob stays inside behind the removable sides.
2026-10-12 docs: step-by-step assembly guide
    New docs/Kubi Assembly Guide.md: battery safety rules, then four stages that each end with a check: the power chain on the bench (cell matching, TP4056, R1 at the holder, MT3608 set to 5 V before anything is connected), the perfboard (sockets jigged with the ESP32, wire order, continuity and short checks), a full bench test with the expected serial lines and the OTA flash of firmware + dashboard, and fitting into the enclosure followed by the face recalibration. Electrolytics only on hand: the sense-node capacitor is dropped (too tall under the ESP32, not needed at 10k); an optional bulk cap on 5 V instead.
    The wiring guide now solders power, amp and batter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
2026-10-21 feat(enclosure): parametric 90 mm cube for PETG, with STLs
    enclosure/kubi_enclosure.scad models the cube in OpenSCAD: a front body (face, rim and four corner posts, printed face down), a screwed-on back (USB-C port with the wall thinned around it so the plug seats, vents, legs for the mid-plate), a mid-plate (battery holder strapped in front, perfboard on standoffs behind), and four removable side panels held by magnets in matching pockets on the panels and the post ledges. 6 mm rounded edges and corners; screen window with a chamfer, speaker grilles and locating brackets on the front.
    All four parts render as single manifold solids (OpenSCAD 2021.01). A fit check in assembled positions fin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
2026-10-21 chore(enclosure): name the front preview for what it shows (the outside)
2026-10-22 fix(enclosure): measured parts; docs: perfboard grid was missing row I
    Magnets are 5 x 2 mm (the default) and the screen's glass is centred on its PCB, so the window offsets stay 0. The perfboard's corner holes are imprecise, so the mid-plate gets solid 7 mm pads to glue to or drill on assembly instead of fixed pilot holes. New *_asm parts export the four bodies in their assembled positions (enclosure/stl/assembly) for the 3D build viewer.
    The wiring guide's ASCII perfboard grid skipped row I, so it drew 13 rows and showed the sockets 8 holes apart instead of the measured 9. The text and wire list were right; the drawing now has all 14 rows.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
2026-10-22 feat(viewer): 3D build viewer for the enclosure and electronics
    A separate React + Vite + three.js app in viewer/ (npm run dev, port 5174). It cannot live in the dashboard: that is flashed to the cube's 896 KB LittleFS.
    - Enclosure tab: the four printed parts from enclosure/stl/assembly in 3D, an explode slider with Explode / Assemble, part toggles, the 32 magnets, and print notes per part.
    - Electronics tab:
    - Fit in the cube: every component inside a see-through enclosure with the wires routed round the mid-plate; exploding pulls the layers apart along the roll axis and the wires follow. Click a part for its size, position, connections and notes; hover a wire to trace it.
    - Perfboard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
2026-11-04 fix(viewer): serve the enclosure STLs as Vite's public directory
    The viewer went blank when the dev server was started through the
    C:\Development junction: Vite resolves fs.allow to the real D: path, but
    its /@fs/ handler strips the drive and re-resolves against the current
    one, so every STL got a 403 and the failed load took down the React tree.
    Serving enclosure/stl/assembly as publicDir avoids /@fs/ URLs altogether,
    works from either path, still needs no copies, and drops the need to let
    the dev server read the whole repo.
2026-11-10 docs, viewer, enclosure: match the perfboard as actually built
    The perfboard plan had the ESP32's pin rows mirrored (with the chip up and
    the antenna left, EN ... VIN is the row nearest you) and 9 holes apart; on
    the real board they are 10 holes (25.4 mm) apart. The guides and the build
    viewer now use the coordinates printed on the board (columns A-T, rows
    01-14): sockets A2-O2 and A12-O12, screen pins A14-H14, IMU J14-M14, R2 at
    D3-D7 with its leg bent onto D2, pigtails at S2/T2/S4/T4/S6 and O14-Q14,
    and the wire list in the order it was soldered.
    The DFRobot 10DOF V2 has straight pins, so it lies flat in its socket with
    its body 26 mm past its pins, about 0.5 mm into the side panel. Every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
2026-11-11 viewer, docs: wire-by-wire guide on the solder side, back-side letters
    - Electronics > "Wire by wire" tab: one wire at a time on the solder side,
    with route, direction, cut length and beep/silent checks.
    - The back of the perfboard has its own printed letters (A-T left to right,
    so A<->T, B<->S, ...). The views and guides now name solder-side holes
    by those letters (backHole() in scad.ts).
    - Audio wires come after their pigtails; the amp input G ground runs
    T4-Q14 up the empty column instead of over the row-13 wire pile.
    - Guides: cross the row-13 wires at right angles, and mount the board on
    2.5-3 mm spacers if the stacks are taller than the 4 mm behind it.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
2026-11-11 fix(audio): fade the DAC up once at boot and hold mid-scale
    On the real cube the 60 ms fade from 0 V to mid-scale around every chime
    went through the PAM8403 as a hard speaker kick. The boot chime lands on
    WiFi start-up, and the two together browned out the ESP32 into a reset
    loop (and tripped the PK4056 protection on battery).
    The DAC now fades up once, over 2 s after boot, and then holds mid-scale
    for good: pump() keeps writing silence in DAC mode, so the DMA never falls
    back to 0 V and chimes start and stop without a step. Verified on the cube
    with the amp knob at a quarter, on PC USB and on battery.
2026-11-11 fix(audio): rest the DAC at 0 V and play chimes as pulses from 0 V up
    37303e3 held the DAC at mid-scale between chimes to avoid per-chime fades.
    On the real cube that failed too: any flash write (OTA, NVS saves such as a
    Pomodoro start/pause, LittleFS) stalls the audio task, the DMA underruns,
    tx_desc_auto_clear drops the DAC to 0 V, and with the amp knob up that
    kick tripped the charger's battery protection or reset the ESP32 (OTA on
    battery failed twice). The raised level also passed the 3.3 V rail's noise
    (the DAC divides that rail) to the speakers as static with a beat.
    Now the DAC rests at 0 V, the level the idle DMA writes anyway, and a chime
    is a pulse wave between 0 V and twice the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
2026-11-11 feat: real battery reading, animated scenes Kubi picks himself, true colours
    Battery (Battery.h, main.cpp, API.cpp)
    - Reads the cell on GPIO 34 through R1/R2 (ratio 9.42/(9.28+9.42)) instead
    of a hard-coded 100 %. Phone-like: ~3 min average, counts only one way.
    - Detects charging/draining/full from the voltage (the charger is not wired
    to the ESP32), estimates minutes to empty or full from a 30-minute trend.
    - Optional charge reminders (unplug at / plug in at): chime plus banner.
    - /api/state: batteryVoltage, batteryState, batteryMinutes, pressure (the
    BMP280 has no humidity), chargeAlertHigh/Low.
    Display
    - The panel is BGR: TFT_RGB_ORDER=0. Every red had shown blue.
    - Scenes are con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
2026-11-11 feat(battery): learn drain and charge rates and keep them across restarts
    The time estimate used only the last 30 minutes held in RAM, so every
    restart meant another 10-minute "estimating". BatteryMonitor now keeps a
    slow average (~1.7 h memory) of every full half-hour trend, per direction,
    in %/h. main.cpp loads it from NVS (drainRate, chargeRate) at boot and
    saves it when it moves by more than 0.05 %/h, checked every 10 minutes.
    The estimate is there straight after a restart from the learned rate; the
    live half-hour trend can move it by up to half once it has 10+ minutes.
2026-11-11 fix(battery): settle after plug/unplug; bigger charge lift; ease the percent
    Seen on the cube: right after plugging in, the estimate said "full in
    17 min" at 79 % (really about an hour), and after charging the shown
    percent fell 92 -> 87 in a few minutes.
    - The trend skips the 10 minutes after a plug-in or unplug, while the slow
    average is still absorbing the ~0.1 V step, so that step is never read
    (or learned) as a very fast charge or drain.
    - The charger lifts the cell ~0.08 V on this pack, not 0.04: compensate that.
    - After a plug-in or unplug the shown percent eases to the new reading, at
    most a point every 2 minutes, instead of jumping.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
2026-11-11 feat: nap - Kubi's software "off", woken by picking him up
    There is no power switch. POST /api/nap (dashboard: Power > Put Kubi to
    sleep, tap twice) makes the hardware loop say good night, arm the ADXL345's
    activity detector (0.5 g, AC-coupled, latching), put the panel to sleep,
    switch WiFi off and deep-sleep the ESP32 with the backlight and both DAC
    pins held low (dark, no hiss). Every 2 s it wakes, reads INT_SOURCE first
    thing in setup() and sleeps again unless Kubi was moved; then it boots
    normally with the wake chime. The ADXL345 INT pin is not wired, hence the
    polling. The amp, boost and DevKit still draw a little: about a week.
    Sim: /api/nap dims the screen until the next gesture or m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
